Teamfortress-dude/Larper-2-Teddyy-/Bill of Materials.csv

Item | Description | Quantity | Unit Price | Total Price | Links
Nozzle | CNC nozzle made of 6061 aluminium | 1 | $81.92 | $73.32 | https://drive.google.com/drive/folders/1I5rtxUQr0osDNQA_9HIpb_R-KsrObc6l?usp=sharing
6061-T6 Pipe | Used as the casing | 1 | $260.00 | $260.00 | https://drive.google.com/drive/folders/1I5rtxUQr0osDNQA_9HIpb_R-KsrObc6l?usp=sharing
Bulkhead | CNC bulkhead made 6061 aluminium | 1 | $40.38 | $36.37 | https://drive.google.com/drive/folders/1I5rtxUQr0osDNQA_9HIpb_R-KsrObc6l?usp=sharing
Nozzle Insert | CNC nozzle insert made of 304 stainless steel | 1 | $108.50 | $105.74 | https://drive.google.com/drive/folders/1I5rtxUQr0osDNQA_9HIpb_R-KsrObc6l?usp=sharing
Pipe Shipping | Cost of Shipping | 1 | $220.00 | $220.00 | https://drive.google.com/drive/folders/1I5rtxUQr0osDNQA_9HIpb_R-KsrObc6l?usp=sharing
CNC shipping | Cost of Shipping | 1 | $9.94 | $9.98 | https://drive.google.com/drive/folders/1I5rtxUQr0osDNQA_9HIpb_R-KsrObc6l?usp=sharing
G56 O-ring | O-ring used for sealing gases in casing | 6 | $1.16 | $6.96 | https://www.tokopedia.com/ichibanseal/oring-g-55-54-4x3-1-id-54-4-mm-x-tebal-3-1-mm-fkm-tahan-panas
M6x14 screw | Used to bolt the closures to the casing | 16 | $0.06 | $0.88 | https://www.tokopedia.com/3dinjakarta/baut-l-button-m6-stainless-steel-iso7380-button-head-screw-hex-socket-10-12-20-m6x10-m6x12-m6x20-1730805433507350293
M6 copper washers | Used as a buffer between the steel screws and aluminium casing so the screws don't bite too much into the casing. | 1 | $0.06 | $0.06 | https://www.tokopedia.com/onefastener/ring-tembaga-m6-atau-6x10
1kg Sorbitol | Used as the fuel of the rocket motor | 1 | $4.38 | $4.38 | https://www.tokopedia.com/putrapanganprima/pemanis-sorbitol-bubuk-powder-serbuk-food-grade-100gr-250gr-500gr-1kg-1-kg-d9cf3
1kg Potassium nitrate | Used as the oxidiser of the rocket motor | 2 | $5.21 | $10.42 | https://www.tokopedia.com/oema-store/terlaris-pupuk-potassium-nitrate-kno3-kingenta-repack-ready-1732713080109630761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
100 g iron oxide | Used as a catalyst in the propellant | 1 | $0.29 | $0.29 | https://www.tokopedia.com/satyasentosa/oker-merah-iron-oxide-red-per-100-gram
RTV silicone | Used to seal the gap between the insert and the nozzle | 1 | $1.59 | $1.59 | https://www.tokopedia.com/satriateknik88/threebond-high-temp-rtv-silicone-75-gr-2-red-lem-gasket-super-sealer-lem-threebond-1104-lem-gasket-paking-cair-25gr-2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
Silicone grease | Used to smooth assembly, seal any small gaps, and slow heat transfer between insulator and casing | 2 | $0.64 | $1.28 | https://www.tokopedia.com/efst/silicone-grease-o-ring-lube-gemuk-sil-rubber-karet-seal-gear-high-temp-1729705061221959855
200 mesh sieve | Used to determine if the milled power is small enough | 1 | $12.18 | $12.18 | https://www.tokopedia.com/propeba-indo/200-mesh-74-micron-sieve-ayakan-stainless-steel-8
Coffee grinder | Used to mill propellant | 1 | $3.33 | $3.33 | https://www.tokopedia.com/lalulaku99/la-natuna-grinder-coffee-electric-alat-penggiling-biji-kopi-elektrik-blender-penggiling-cabe-bumbu-kacang-portable-serbag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
Tokopedia shipping | This value is honestly an educated guess as the shipping costs on Tokopedia fluctuate a lot but based on my many years of buying there, this should be enough. | 1 | $10.00 | $10.00
 |  |  | Total Cost: | $756.78
