Teamfortress-dude/Larper-2-Teddyy-/.STEP Files/Bulkhead.step

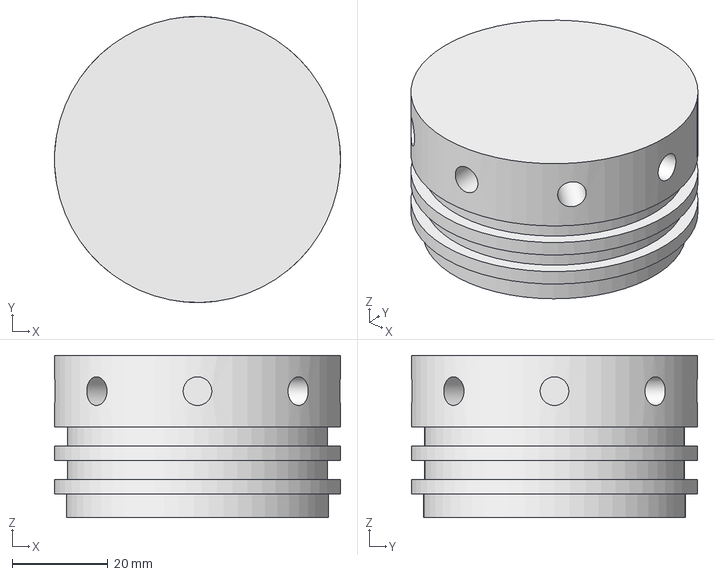
[picture p2: CAD file, 2026-10-17]
.STEP Files/Bulkhead.step
59.9 x 59.9 x 34.0 mm
