Teamfortress-dude/Larper-2-Teddyy-/.STEP Files/Casing.step

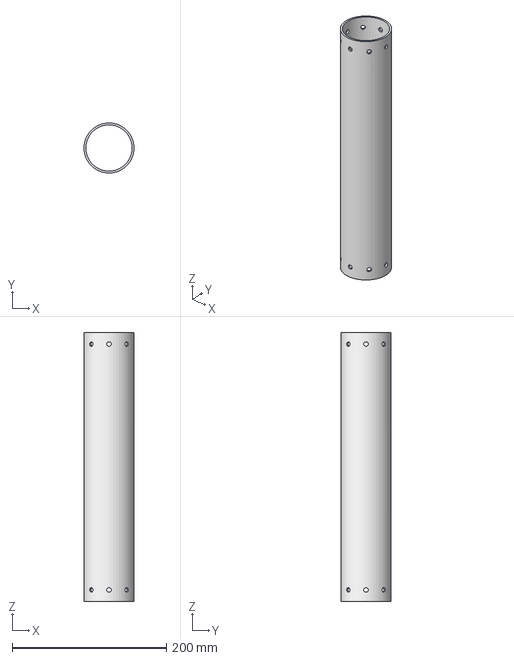
[picture p3: CAD file, 2026-10-17]
.STEP Files/Casing.step
65.0 x 65.0 x 349.0 mm
