Teamfortress-dude/Larper-2-Teddyy-/.STEP Files/Graphite Insert.step

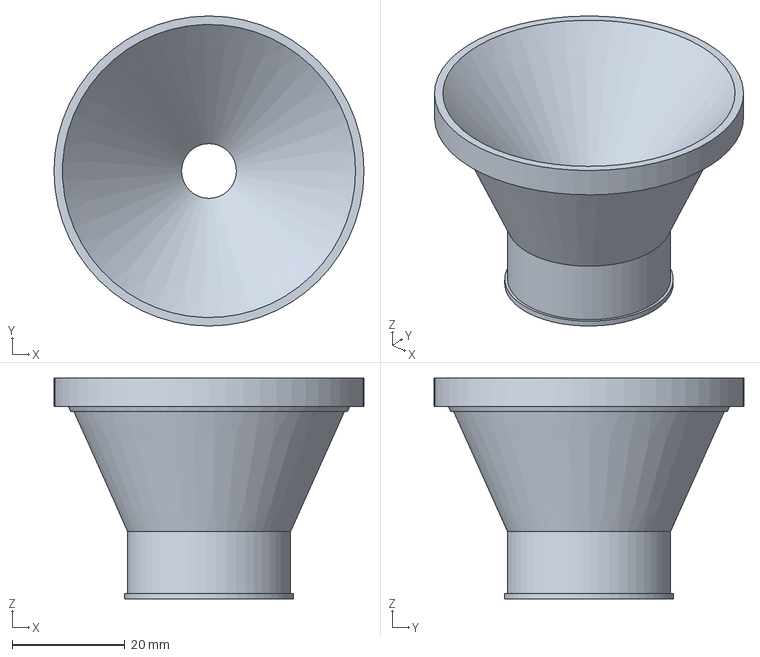
[picture p4: CAD file, 2026-10-17]
.STEP Files/Graphite Insert.step
55.0 x 55.0 x 39.2 mm
