Teamfortress-dude/Larper-2-Teddyy-/.STEP Files/Nozzle.step

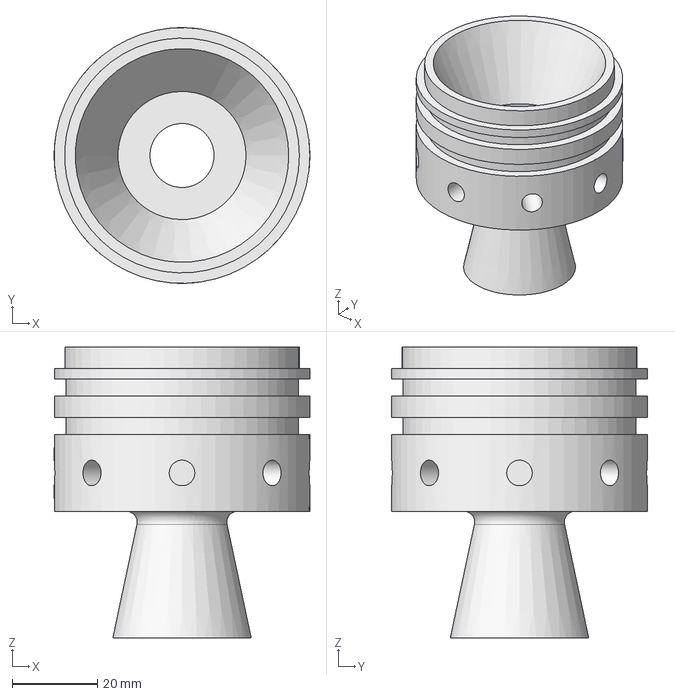
[picture p5: CAD file, 2026-10-17]
.STEP Files/Nozzle.step
59.9 x 59.9 x 68.2 mm
