Teamfortress-dude/Larper-2-Teddyy-/Technical Drawings/Bulkhead Drawing.pdf

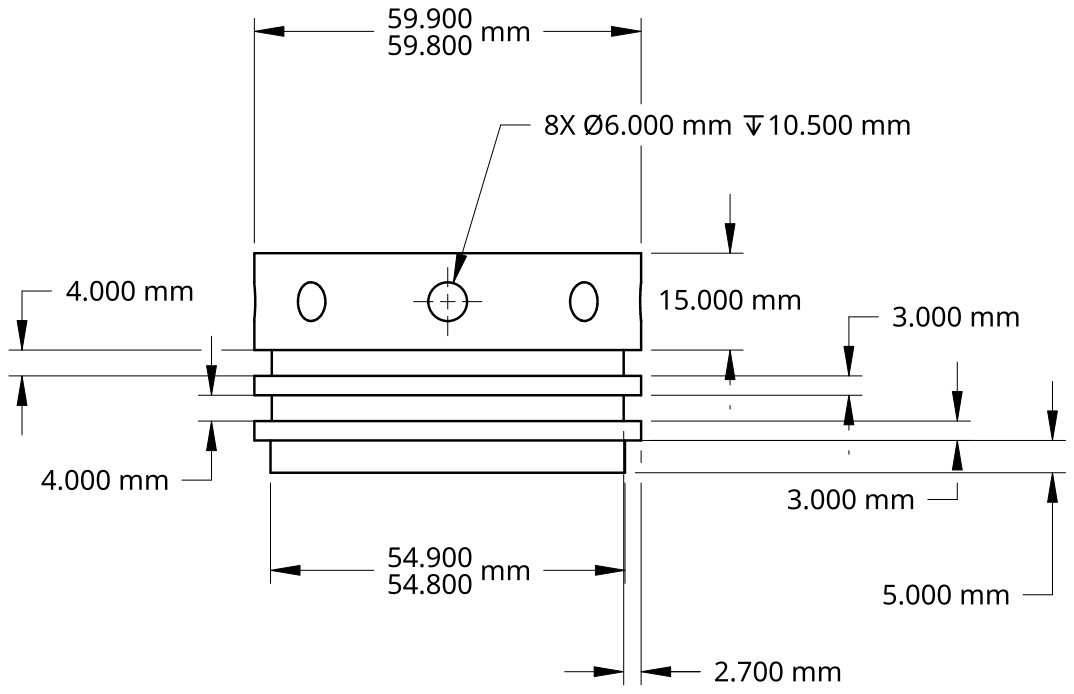
[picture p6: page 1]
