Teamfortress-dude/Larper-2-Teddyy-/Technical Drawings/Casing Drawing.pdf

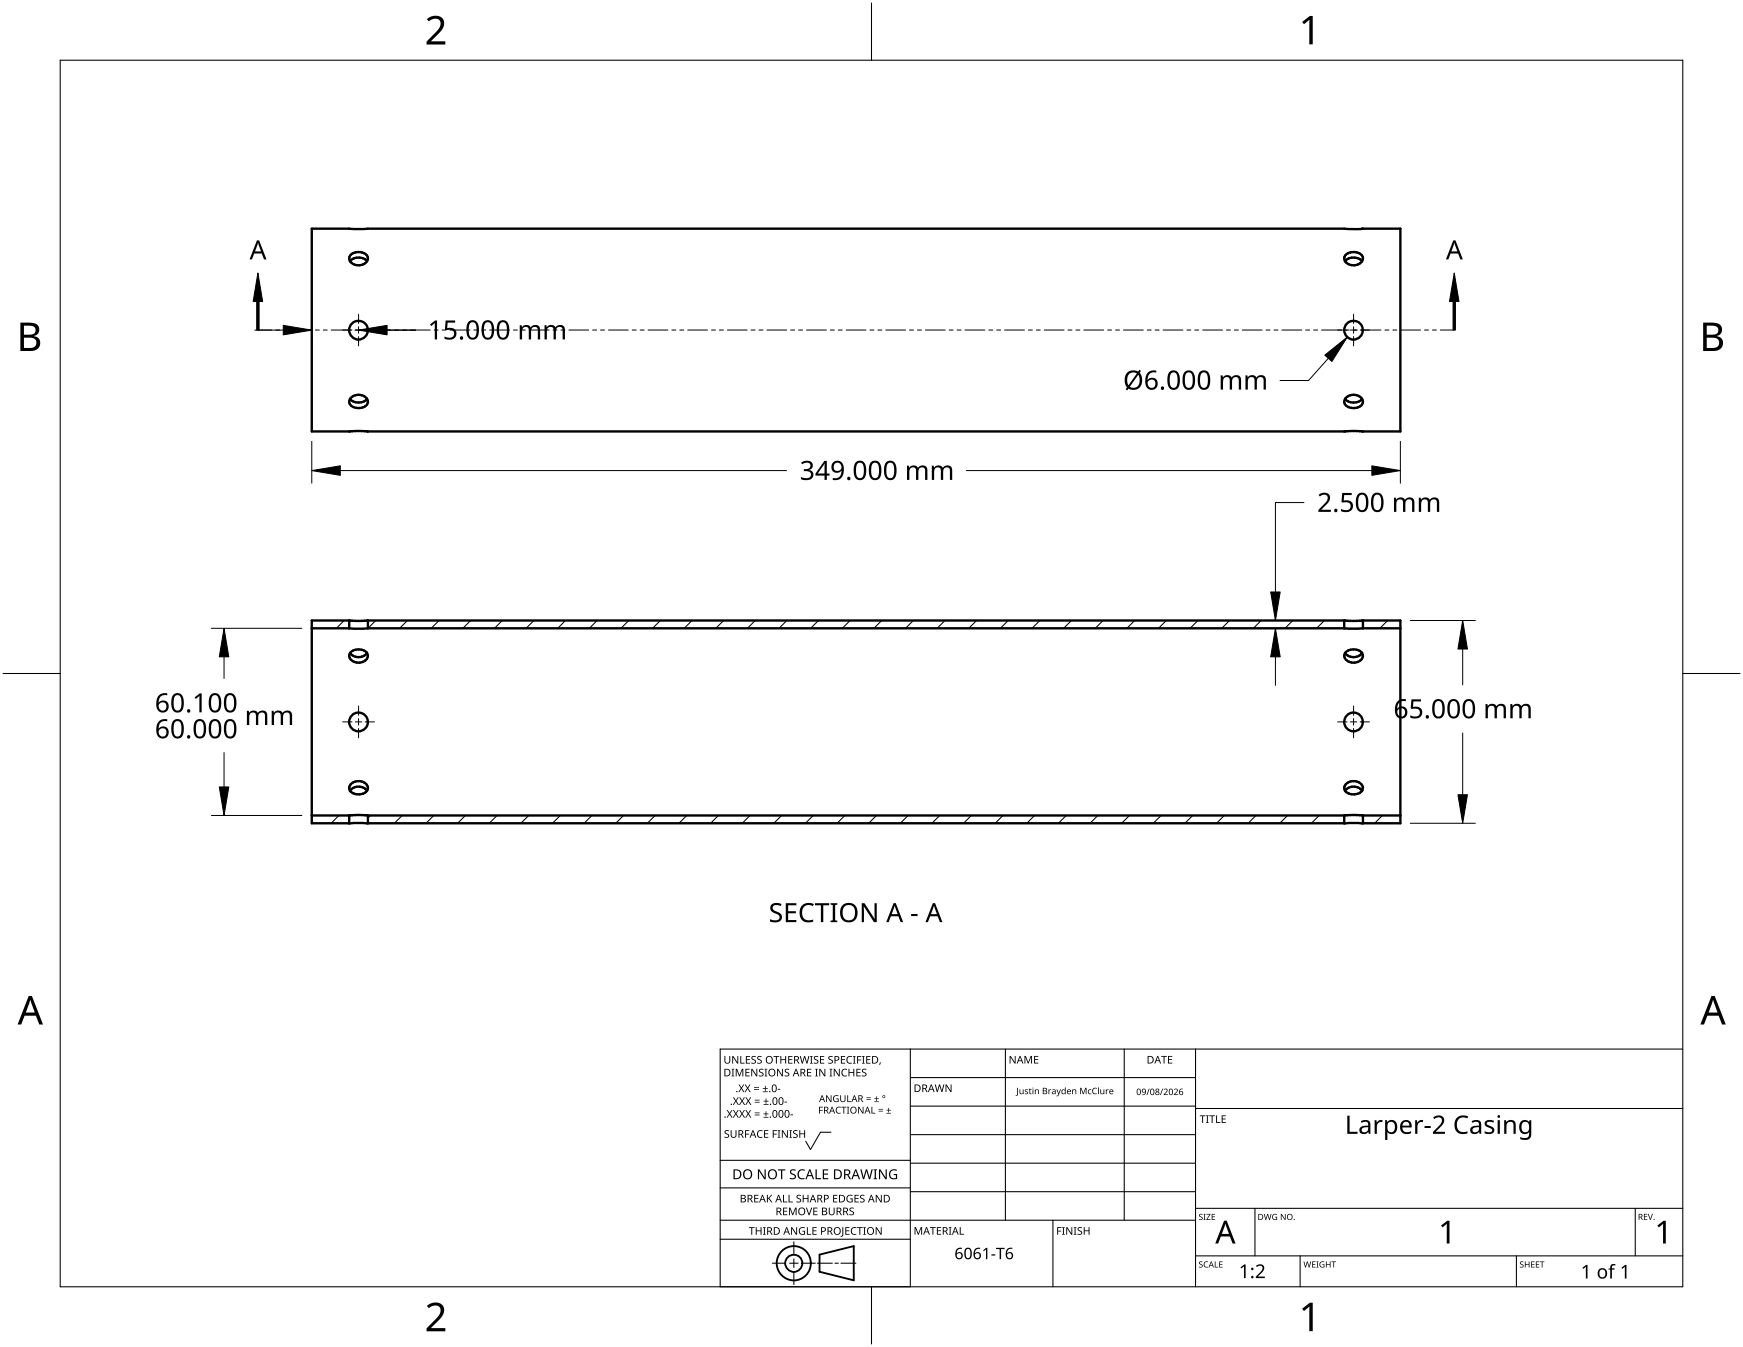
[picture p7: page 1]
