Teamfortress-dude/Larper-2-Teddyy-/Technical Drawings/Graphite Insert.pdf

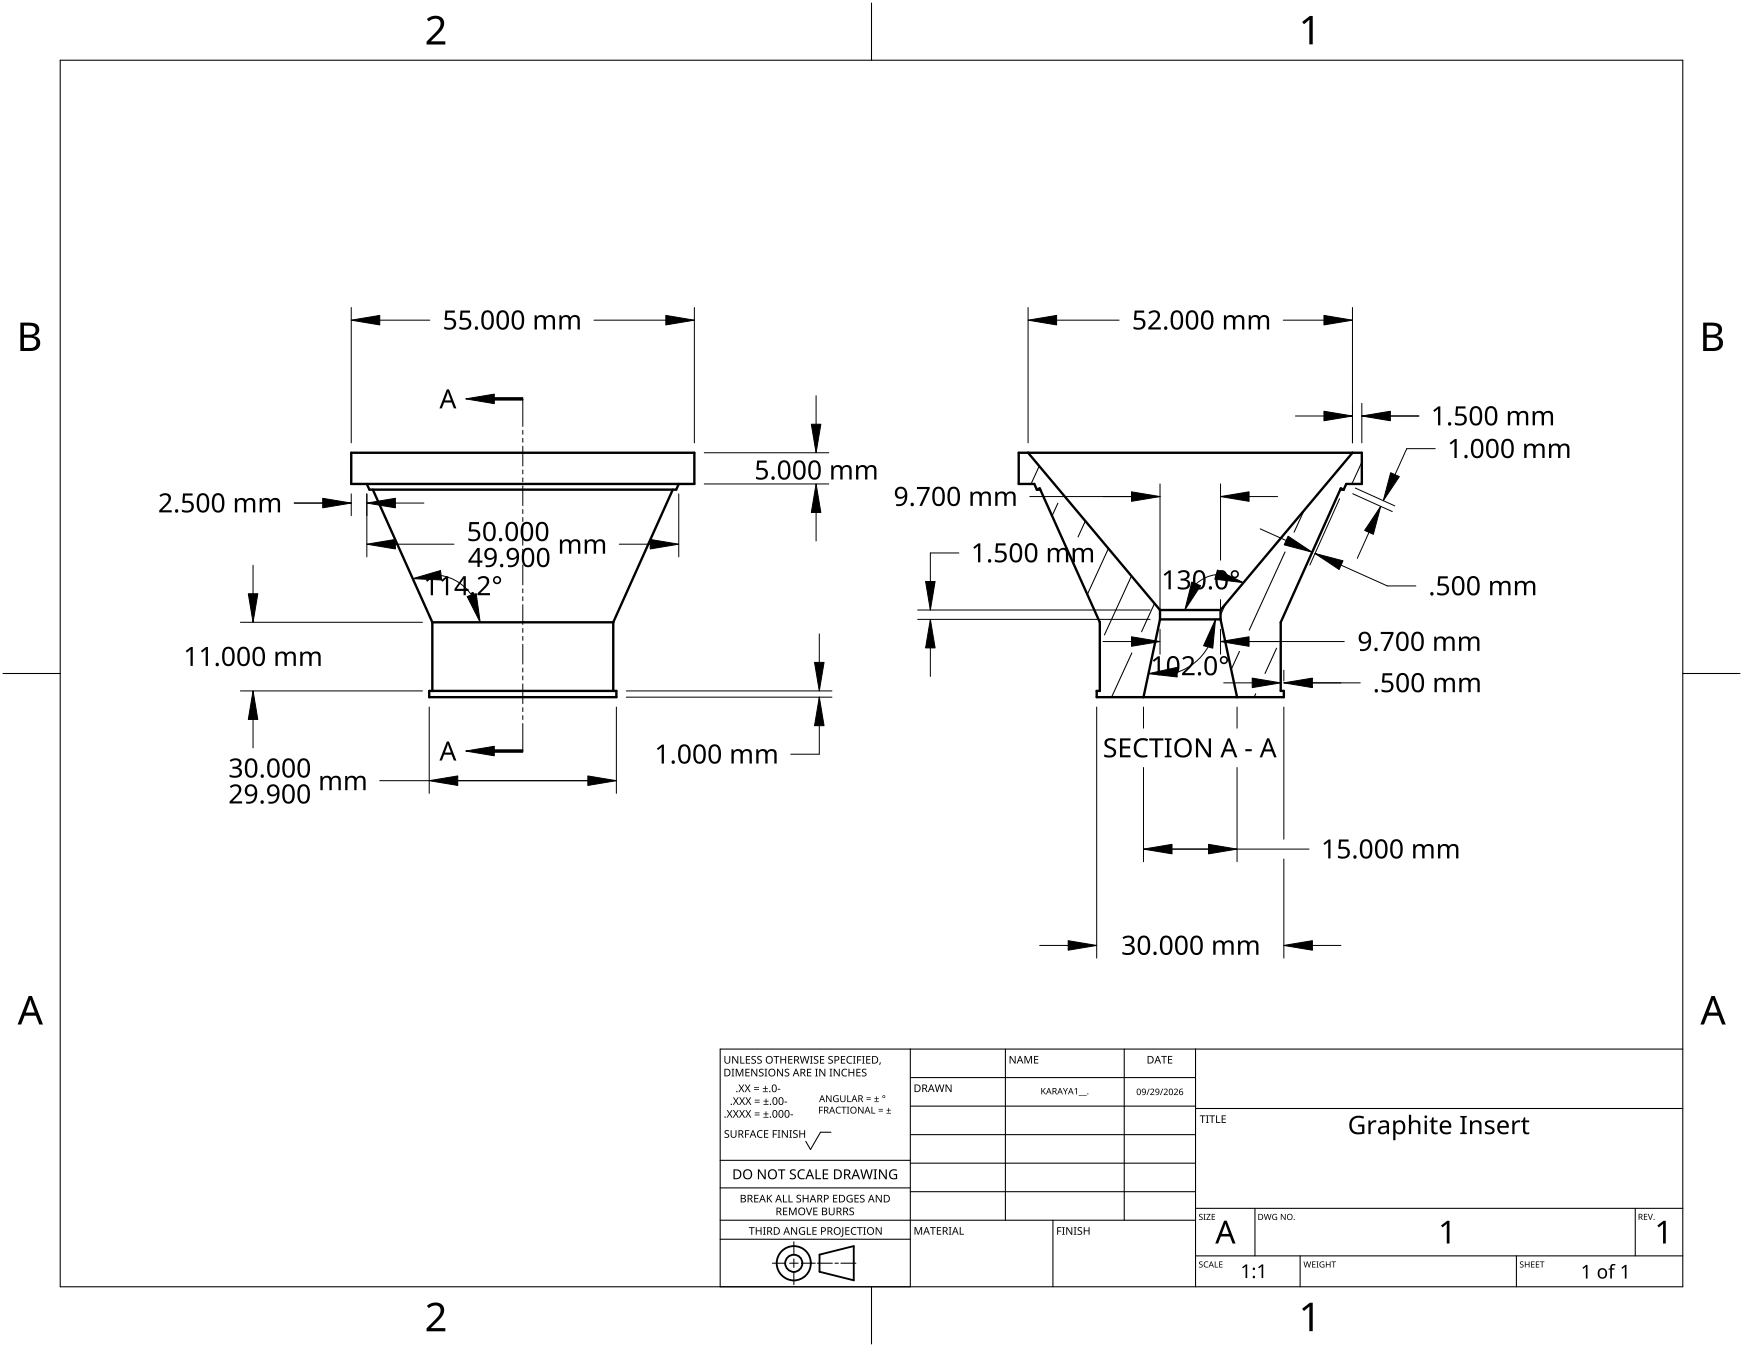
[picture p8: page 1]
