Teamfortress-dude/Larper-2-Teddyy-/Technical Drawings/Nozzle Drawing.pdf

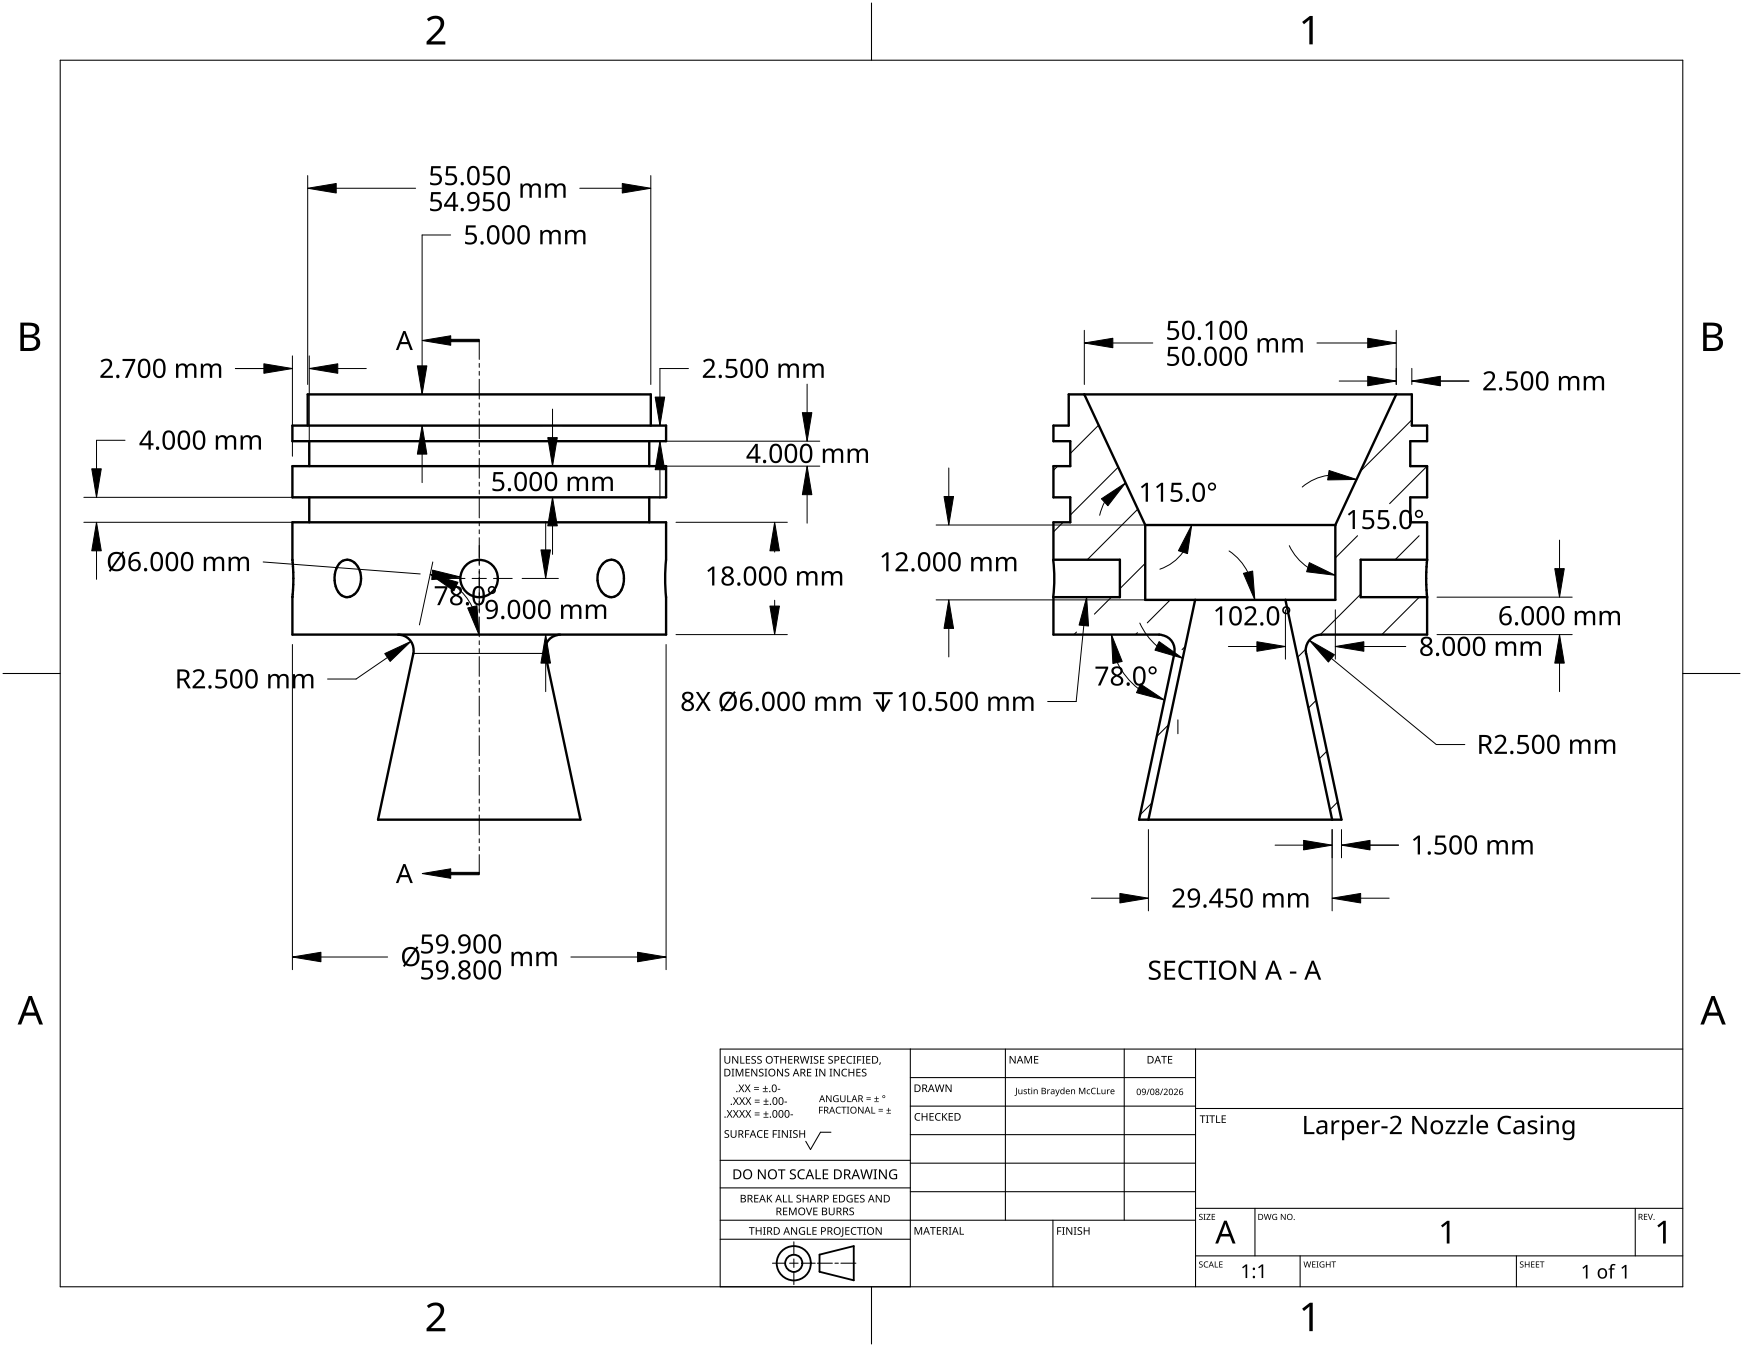
[picture p9: page 1]
